anderssonemil/M8N-GPS-Data-Logger/SD Card Files/README.md

# SD Card files
COUNTER.txt keeps track of last saved file number
Config.txt can be changed for different sampeling rates.
0 for 10 Hz
1 for 5 Hz
2 for 1 Hz
