anderssonemil/M8N-GPS-Data-Logger/Code/README.md

# Comments

The code need ot be cleaned up some. Perhaps I'll turn some in to new Librarys, like the LED blink part that I could use in future projects.
