anderssonemil/M8N-GPS-Data-Logger/Prototype box inside.jpg

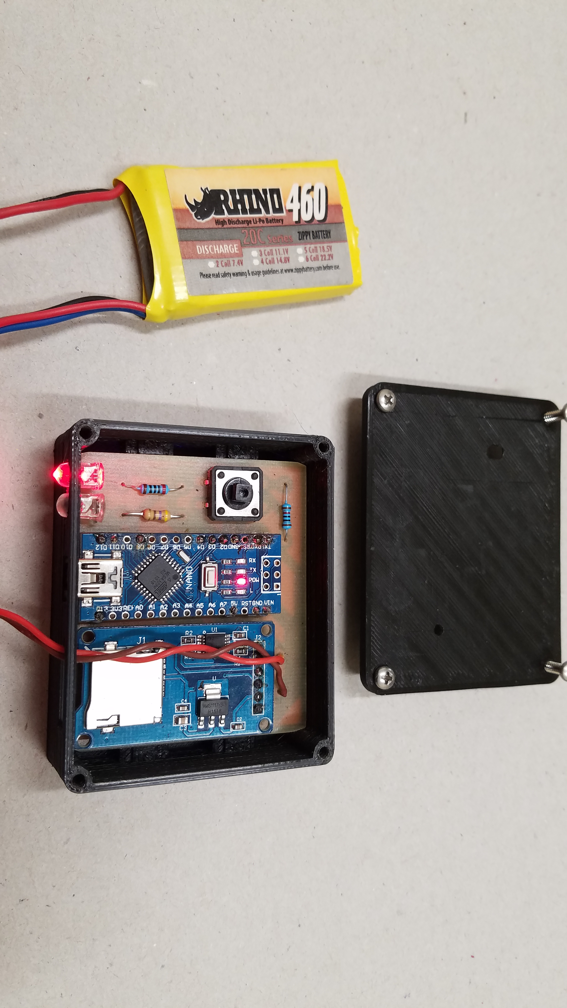
Prototype box inside.jpg
