anderssonemil/M8N-GPS-Data-Logger/(commit log)

2016-12-16 SD counter file
    File saved on SD card to keep track of last saved file
    [Config.txt]
2016-12-16 Revert "SD counter file"
    This reverts commit c825b3ed1c4d5b24771021f1bfd1c1c6af2d1d33.
    [Config.txt]
2016-12-16 Configuration and Counter file
    Added files that need to be placed on the SD card
    [Config.txt]
2016-12-16 Revised Code
    Made a few smaller changes to the code.
    Revised Blink behaviiour to to save power and fixed a Longitude/Latitude
    conversion error.
    [Ublox_PVT_12-16-16.ino, misc_support_code.ino]
2016-12-16 New Components
    Added pictures of new assembly and new circuite board.
2016-12-16 Schematic
    Added Schematic
2016-12-16 Schematic
    Updated resistor value
2016-12-19 Added prototype box
